jecassis/wave-bubble/Wave Bubble/wavebubble.c

/*
 * wavebubble.c
 *
 * Wave Bubble Hardware Firmware and Tests
 *
 * Firmware to test and operate the Wave Bubble hardware.
 * For questions, bug reports or problems use the forum at:
 * http://forums.adafruit.com/viewforum.php?f=16
 *
 * Copyright (c) 2020 Jimmy Cassis
 *
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
 */

#include "wavebubble.h"

#include <avr/interrupt.h>
#include <avr/pgmspace.h>
#ifndef TEST
#include <avr/cpufunc.h>
#include <avr/eeprom.h>
#include <ctype.h>
#include <util/delay.h>
#else
#include "test.h"
#endif
#include "pll.h"
#include "serial.h"
#include "tuner.h"

#ifdef TEST
volatile char in_char = 0;
#else // OPERATION
uint8_t EEMEM settings_ee;      // Offset to save setting (EEPROM byte offset: 0x06)
uint8_t EEMEM curr_program = 0; // Number of program in use (EEPROM byte offset: 0x05)
uint8_t EEMEM num_programs = 0; // Number of programs in EEPROM (EEPROM byte offset: 0x04)
uint16_t EEMEM validity = 0;    // Validity value to check for empty EEPROM (EEPROM byte offset: 0x02)
uint16_t EEMEM dummy = 0;       // A dummy word to prevent data corruption (EEPROM byte offset: 0x00)

volatile uint16_t global_delay = 0; // Milliseconds delay counter, decremented by ISR
volatile uint16_t led_delay = 0;    // LED blink timer
volatile uint16_t key_delay = 0;    // Key press timer to debounce and detect short and long presses
volatile uint8_t lowbatt_timer = 0; // One second timer for low battery threshold
#endif

/*
 * Power device off
 *
 */
static void power_off(void) {
  usart_puts_P(PSTR("Powering OFF...\n"));
  delay_ms(400);

  // Power OFF device
#ifdef HW_REV_A
  POWERON_PORT |= _BV(POWERON);
#else
  POWERON_PORT &= ~_BV(POWERON);
#endif
}

#ifdef TEST

/*
 * The main test function.
 *
 */
int main(void) {
  // Power on switch pin output and force high to keep device running
  POWERON_PORT |= _BV(POWERON);
  POWERON_DDR |= _BV(POWERON);

  // Initialize serial communication
  usart_init();

  DDRD |= _BV(PD1); // USART TxD0 output

  // LED pin output and LED off
  LEDDDR |= _BV(LED);
  LEDPORT &= ~_BV(LED);

  // Setup port and pins for SPI to digitally-controlled variable resistor
  SPICS_DDR |= _BV(SPICS);
  SPISDO_DDR |= _BV(SPISDO);
  SPICLK_DDR |= _BV(SPICLK);

  SPICS_PORT |= _BV(SPICS);
  SPICLK_PORT &= ~_BV(SPICLK);

  // Setup VCO power control port and pins
  POWERCTL1_DDR |= _BV(POWERCTL1);
  POWERCTL2_DDR |= _BV(POWERCTL2);
  POWERCTL1_PORT &= ~_BV(POWERCTL1); // Turn off VCO1+gain stage
  POWERCTL2_PORT &= ~_BV(POWERCTL2); // Turn off VCO2+gain stage

  // Initialize tuning voltage generator
  init_pwm();

  // Initialize PLL control
  pll_init();

  // Set digital potentiometer to minimum
  set_resistor(BANDWADJ1_RES, 0);
  set_resistor(BANDWADJ2_RES, 0);

  // Set NE555 mode
  set_sawtooth_low();

  usart_puts_P(PSTR("Wave Bubble - Hardware Test\nFW: " __DATE__ " / " __TIME__ "\n\n"));

  usart_puts_P(PSTR("Serial connection test passed.\n\n"));

  usart_puts_P(PSTR("Select a test:\n"));
  usart_puts_P(PSTR("a - Power/Program LED test\n"));             // TP1
  usart_puts_P(PSTR("b - NE555 low frequency mode\n"));           // TP2
  usart_puts_P(PSTR("c - NE555 high frequency mode\n"));          // TP2
  usart_puts_P(PSTR("d - Digital potentiometer sweep\n"));        // TP3 + TP4
  usart_puts_P(PSTR("e - Set digital potentiometer minimum\n"));  // TP3 + TP4
  usart_puts_P(PSTR("f - Set digital potentiometer maximum\n"));  // TP3 + TP4
  usart_puts_P(PSTR("g - Power switch VCO1 (HI) test\n"));        // TP5
  usart_puts_P(PSTR("h - Power switch VCO2 (LO) test\n"));        // TP6
  usart_puts_P(PSTR("i - VCO1 (HI) power toggle\n"));             // TP5
  usart_puts_P(PSTR("j - VCO2 (LO) power toggle\n"));             // TP6
  usart_puts_P(PSTR("k - PWM tuning voltage generator sweep\n")); // TP7 + TP8
  usart_puts_P(PSTR("l - Set PWM tuning voltage minimum\n"));     // TP7 + TP8
  usart_puts_P(PSTR("m - Set PWM tuning voltage maximum\n"));     // TP7 + TP8
  usart_puts_P(PSTR("n - Increase PWM tuning voltage by 1\n"));   // TP7 + TP8
  usart_puts_P(PSTR("o - Decrease PWM tuning voltage by 1\n"));   // TP7 + TP8
  usart_puts_P(PSTR("p - VCO sweep test\n"));                     // TP9 + TP10
  usart_puts_P(PSTR("q - PLL test 1 - DATA signal 5Hz\n"));       // TP11 + TP12
  usart_puts_P(PSTR("r - PLL test 2 - RF stage\n"));              // TP13
  usart_puts_P(PSTR("s - PLL test 2 - IF stage\n"));              // TP14
  usart_puts_P(PSTR("\nz - Power OFF\n"));

  sei();

  uint16_t ocr_val = 0;

  for (;;) {
    switch (in_char) {
      case 'a':
        test_led();
        break;
      case 'b':
        set_sawtooth_low();
        break;
      case 'c':
        set_sawtooth_high();
        break;
      case 'd':
        test_resistors();
        break;
      case 'e':
        set_resistor(BANDWADJ1_RES, 0);
        set_resistor(BANDWADJ2_RES, 0);
        break;
      case 'f':
        set_resistor(BANDWADJ1_RES, 255);
        set_resistor(BANDWADJ2_RES, 255);
        break;
      case 'g':
        test_powerswitch1();
        break;
      case 'h':
        test_powerswitch2();
        break;
      case 'i':
        OCR1A = 0;
        set_resistor(BANDWADJ1_RES, 0);
        POWERCTL2_PORT &= ~_BV(POWERCTL2);
        POWERCTL1_PORT ^= _BV(POWERCTL1);
        in_char = 0;
        break;
      case 'j':
        OCR1B = 0;
        set_resistor(BANDWADJ2_RES, 0);
        POWERCTL1_PORT &= ~_BV(POWERCTL1);
        POWERCTL2_PORT ^= _BV(POWERCTL2);
        in_char = 0;
        break;
      case 'k':
        test_dc();
        break;
      case 'l':
        OCR1A = 0;
        OCR1B = 0;
        ocr_val = 0;
        break;
      case 'm':
        OCR1A = 4095;
        OCR1B = 4095;
        ocr_val = 4095;
        break;
      case 'n':
        if (ocr_val < 4096) {
          ++ocr_val;
          OCR1A = OCR1B = ocr_val;
        }
        in_char = 0;
        break;
      case 'o':
        if (ocr_val > 0) {
          --ocr_val;
          OCR1A = OCR1B = ocr_val;
        }
        in_char = 0;
        break;
      case 'p':
        test_vcos();
        break;
      case 'q':
        test_pll1();
        break;
      case 'r':
        test_pll2_rf();
        break;
      case 's':
        test_pll2_if();
        break;
      case 'z':
        power_off();
        break;
      default:
        break;
    }
  }

  return 0;
}

#else // OPERATION

/*
 * Milliseconds delay function using 1ms system tick from timer0.
 *
 * ms: Number of milliseconds to delay
 *
 */
void delay_ms(uint16_t ms) {
  global_delay = ms;

  // `global_delay' will be decreased in timer 0's ISR
  while (global_delay > 0) {
    _NOP();
  }
}

/*
 * Check the validity of EEPROM content and initialize if necessary.
 *
 */
static void init_eeprom(void) {
  uint16_t i, temp;
  uint8_t *p = 0;

  // Read validity word
  temp = eeprom_read_word(&validity);

  // Check validity, 0xBEEF is good here.
  if (temp != 0xEFBE) { // Not correct? Init EEPROM.
    for (i = 0; i < E2END + 1; ++i) {
      eeprom_write_byte(p++, 0x00);
    }
  }
  eeprom_write_word(&validity, 0xEFBE);
}

/*
 * Print menu on terminal.
 *
 */
static void print_menu(void) {
  print_div();
  usart_puts_P(PSTR("p - Display programs\n"));
  usart_puts_P(PSTR("a - Add program\n"));
  usart_puts_P(PSTR("t - Tune program\n"));
  usart_puts_P(PSTR("d - Delete program\n"));
  usart_puts_P(PSTR("e - Delete all programs\n"));
  usart_puts_P(PSTR("q - Quit menu\n"));
  usart_puts_P(PSTR("o - Power off\n"));
  print_div();
  usart_puts_P(PSTR("=> "));
}

/*
 * Print program details on terminal.
 *
 * setting: Jammer setting struct
 * n:       Program number
 * m:       Total number of programs
 *
 */
static void print_program(jammer_setting *setting, uint8_t n, uint8_t m) {
  usart_puts_P(PSTR("Program number "));
  putnum_ud(n + 1);
  usart_puts_P(PSTR(" of "));
  putnum_ud((uint16_t)m);
  usart_putc('\n');

  usart_puts_P(PSTR("Low band VCO: "));
  if (setting->startfreq2 == 0) {
    usart_puts_P(PSTR("Off"));
  } else {
    putnum_ud(setting->startfreq2);
    usart_puts_P(PSTR(" -> "));
    putnum_ud(setting->endfreq2);
    usart_puts_P(PSTR(" ("));
    putnum_ud(setting->dc_offset2);
    usart_puts_P(PSTR(", "));
    putnum_ud(setting->bandwidth2);
    usart_putc(')');
  }
  usart_puts_P(PSTR("\nHigh band VCO: "));
  if (setting->startfreq1 == 0) {
    usart_puts_P(PSTR("Off"));
  } else {
    putnum_ud(setting->startfreq1);
    usart_puts_P(PSTR(" -> "));
    putnum_ud(setting->endfreq1);
    usart_puts_P(PSTR(" ("));
    putnum_ud(setting->dc_offset1);
    usart_puts_P(PSTR(", "));
    putnum_ud(setting->bandwidth1);
    usart_putc(')');
  }
  usart_puts_P(PSTR("\n\n"));
}

/*
 * Print all programs on terminal.
 *
 */
static void display_programs(void) {
  uint8_t i, progs;
  jammer_setting setting;

  progs = eeprom_read_byte(&num_programs);
  if (progs > MAX_PROGRAMS) {
    progs = MAX_PROGRAMS;
  }

  putnum_ud(progs);
  usart_puts_P(PSTR(" of "));
  putnum_ud(MAX_PROGRAMS);
  usart_puts_P(PSTR(" programs in memory.\n\n"));

  for (i = 0; i < progs; ++i) {
    eeprom_read_block(&setting,
                      &settings_ee + sizeof(jammer_setting) * i,
                      sizeof(jammer_setting));
    print_program(&setting, i, progs);
  }
}

/*
 * Delete program from EEPROM.
 *
 */
static void delete_program(void) {
  uint8_t n, progs;
  jammer_setting setting;

  if (eeprom_read_byte(&num_programs) == 0) {
    usart_puts_P(PSTR("No programs stored.\n\n"));
    return;
  }

  display_programs();
  usart_puts_P(PSTR("Delete program number: "));
  n = usart_get16();
  progs = eeprom_read_byte(&num_programs);
  if (progs > MAX_PROGRAMS) {
    progs = MAX_PROGRAMS;
  }

  if ((n == 0) || (n > progs)) {
    usart_puts_P(PSTR("Invalid program number.\n\n"));
    return;
  }

  if (n == progs) {
    // Reduce program count
    eeprom_write_byte(&num_programs, progs - 1);
  } else {
    // Delete desired program
    for (; n < progs; ++n) {
      // Shift trailing program blocks
      eeprom_read_block(&setting,
                        &settings_ee + sizeof(jammer_setting) * n,
                        sizeof(jammer_setting));

      eeprom_write_block(&setting,
                         &settings_ee + sizeof(jammer_setting) * (n - 1),
                         sizeof(jammer_setting));

      // Remove deleted program from count
      eeprom_write_byte(&num_programs, progs - 1);
    }
  }
  usart_putc('\n');
}

/*
 * Tune setting on VCOs and save tuning values.
 *
 * n:    Number of program to tune
 * save: If true, save back tuning values
 *
 */
static void tune_it(uint8_t n, uint8_t save) {
  jammer_setting setting;

  eeprom_read_block(&setting,
                    &settings_ee + sizeof(jammer_setting) * n,
                    sizeof(jammer_setting));

  // Tune low band VCO
  if ((setting.startfreq2 != 0) && (setting.endfreq2 != 0)) {
    setting.bandwidth2 = tune_rf_band(setting.startfreq2, setting.endfreq2, 1);
    setting.dc_offset2 = OCR1B;
  }

  // Tune high band VCO
  if ((setting.startfreq1 != 0) && (setting.endfreq1 != 0)) {
    setting.bandwidth1 = tune_rf_band(setting.startfreq1, setting.endfreq1, 0);
    setting.dc_offset1 = OCR1A;
  }

  if (save) {
    eeprom_write_block(&setting,
                       &settings_ee + sizeof(jammer_setting) * n,
                       sizeof(jammer_setting));
  }
}

/*
 * Tune specific program.
 *
 */
static void tune_program(void) {
  uint8_t n;

  if (eeprom_read_byte(&num_programs) == 0) {
    usart_puts_P(PSTR("No programs stored.\n\n"));
    return;
  }

  display_programs();
  usart_puts_P(PSTR("Tune program number: "));
  n = usart_get16();
  if (n > eeprom_read_byte(&num_programs)) {
    usart_puts_P(PSTR("Invalid program number.\n\n"));
  } else {
    tune_it(n - 1, 1);
  }
}

/*
 * Add program to jammer and store in EEPROM
 *
 */
static void add_program(void) {
  jammer_setting new_setting;
  uint8_t progs;

  progs = eeprom_read_byte(&num_programs);
  if (progs >= MAX_PROGRAMS) {
    usart_puts_P(PSTR("Memory full.\n\n"));
    return;
  }

  usart_puts_P(PSTR("Enter start and stop frequency for each VCO or 0 to turn off VCO.\n"));
  usart_puts_P(PSTR("Low Band: 345-1350MHz -- High Band 1225-2715MHz\n"));

lowbandstart:
  usart_puts_P(PSTR("\nLow band VCO\nStart (in MHz): "));
  new_setting.startfreq2 = usart_get16();
  if (new_setting.startfreq2 == 0) {
    new_setting.endfreq2 = 0;
    goto highbandstart;
  }
  if (new_setting.startfreq2 < LOWBAND_VCO_LOW) {
    usart_puts_P(PSTR("Frequency too low.\n"));
    goto lowbandstart;
  }

lowbandend:
  usart_puts_P(PSTR("End (in MHz): "));
  new_setting.endfreq2 = usart_get16();
  if (new_setting.endfreq2 == 0) {
    new_setting.startfreq2 = 0;
    goto highbandstart;
  }
  if (new_setting.endfreq2 > LOWBAND_VCO_HIGH) {
    usart_puts_P(PSTR("Frequency too high.\n"));
    goto lowbandend;
  }
  if (new_setting.endfreq2 < new_setting.startfreq2) {
    usart_puts_P(PSTR("End frequency lower than start.\n"));
    goto lowbandend;
  }

highbandstart:
  usart_puts_P(PSTR("\nHigh band VCO\nStart (in MHz): "));
  new_setting.startfreq1 = usart_get16();
  if (new_setting.startfreq1 == 0) {
    new_setting.endfreq1 = 0;
    goto saveprog;
  }
  if (new_setting.startfreq1 < HIGHBAND_VCO_LOW) {
    usart_puts_P(PSTR("Frequency too low.\n"));
    goto highbandstart;
  }

highbandend:
  usart_puts_P(PSTR("End (in MHz): "));
  new_setting.endfreq1 = usart_get16();
  if (new_setting.endfreq1 == 0) {
    new_setting.startfreq1 = 0;
    goto saveprog;
  }
  if (new_setting.endfreq1 > HIGHBAND_VCO_HIGH) {
    usart_puts_P(PSTR("Frequency too high.\n"));
    goto highbandend;
  }
  if (new_setting.endfreq1 < new_setting.startfreq1) {
    usart_puts_P(PSTR("End frequency lower than start.\n"));
    goto highbandend;
  }

saveprog:
  if ((new_setting.startfreq1 == 0) && (new_setting.startfreq2 == 0)) {
    usart_puts_P(PSTR("\nNothing to save.\n\n"));
    return;
  }
  new_setting.dc_offset1 = new_setting.dc_offset2 = 0;
  new_setting.bandwidth1 = new_setting.bandwidth2 = 0;

  eeprom_write_block(&new_setting,
                     &settings_ee + sizeof(jammer_setting) * progs,
                     sizeof(jammer_setting));

  eeprom_write_byte(&num_programs, progs + 1);
  usart_puts_P(PSTR("\nSaved program number "));
  putnum_ud(progs + 1);
  usart_puts_P(PSTR(".\n\n"));
}

/*
 * Print menu and wait for users input.
 *
 */
static void run_menu(void) {
  char c;

  do {
    print_menu();
    c = usart_getc();
    usart_putc(c);
    usart_putc('\n');
    switch (c) {
      case 'p':
        display_programs();
        break;
      case 'a':
        add_program();
        break;
      case 't':
        tune_program();
        break;
      case 'd':
        delete_program();
        break;
      case 'e':
        usart_puts_P(PSTR("Delete all programs? y/n: "));
        c = usart_getc();
        usart_putc(c);
        usart_puts_P(PSTR("\n\n"));
        if (c == 'y') {
          eeprom_write_word(&validity, 0x0000);
          init_eeprom();
        }
        break;
      case 'q':
        break;
      case 'o':
        power_off();
        break;
      default:
        usart_puts_P(PSTR("Unknown command.\n\n"));
        break;
    }
  } while (c != 'q');
}

/*
 * The main operational function.
 *
 */
int main(void) {
  // Calibrate internal RC oscillator
  // 0x5A read from ATmega168
  // OSCCAL = 0xC0;

  // Setup system tick counter
  OCR0A = 125; // timer0 capture at 1ms
  TCCR0A |= _BV(WGM01);
  TCCR0B |= _BV(CS01) | _BV(CS00); // Set timer0 CTC mode, prescaler 64
  TIMSK0 |= _BV(OCIE0A);           // Enable timer0 output compare interrupt

  sei(); // Enable global interrupts

  key_delay = 0;
  // Power key must be pressed at least 2 seconds to power ON
  while (key_delay < 2000) {
    _NOP();
  }

  // Power ON switch pin output and force HIGH to keep device running
  POWERON_PORT |= _BV(POWERON);
  POWERON_DDR |= _BV(POWERON);

  // Initialize serial communication
  usart_init();

  DDRD |= _BV(PD1); // USART TxD0 output

  // LED pin output and LED on
  LEDDDR |= _BV(LED);
  LEDPORT |= _BV(LED);

  // Program key input and pull-up
  PROGKEY_PORT |= _BV(PROGKEY);
  PROGKEY_DDR &= ~_BV(PROGKEY);

  // Setup port and pins for software SPI operation to control digital potentiometer
  SPICS_DDR |= _BV(SPICS);
  SPISDO_DDR |= _BV(SPISDO);
  SPICLK_DDR |= _BV(SPICLK);

  SPICS_PORT |= _BV(SPICS);
  SPICLK_PORT &= ~_BV(SPICLK);

  // Setup VCO power control port and pins
  POWERCTL1_DDR |= _BV(POWERCTL1);
  POWERCTL2_DDR |= _BV(POWERCTL2);
  POWERCTL1_PORT &= ~_BV(POWERCTL1); // Turn off VCO1 and gain stage
  POWERCTL2_PORT &= ~_BV(POWERCTL2); // Turn off VCO2 and gain stage

  // Initialize tuning voltage generator
  init_pwm();

  // Initialize PLL control
  pll_init();

  // Set digital potentiometer to minimum
  set_resistor(BANDWADJ1_RES, 0);
  set_resistor(BANDWADJ2_RES, 0);

  // Set NE555 mode
  set_sawtooth_low();

  // Check EEPROM validity
  init_eeprom();

  usart_puts_P(PSTR("Wave Bubble\nFW: " __DATE__ " / " __TIME__ "\n\n"));

  uint8_t progs, program_num;
  jammer_setting setting;

  progs = eeprom_read_byte(&num_programs);
  if (progs > MAX_PROGRAMS) {
    progs = MAX_PROGRAMS;
  }

  if (progs != 0) {
    usart_puts_P(PSTR("Press key to enter menu...\n"));
    delay_ms(2000);
  }

no_progs: // Go here in case 'q' is pressed and no programs are stored
  if ((UCSR0A & _BV(RXC0)) && isascii(usart_getc())) {
    usart_putc('\n');
    run_menu();
  } else if (progs == 0) {
    run_menu();
  }

run_prog: // Go here when program key is pressed, switch to next program
  progs = eeprom_read_byte(&num_programs);
  if (progs == 0) {
    usart_puts_P(PSTR("No programs stored.\n\n"));
    goto no_progs;
  } else if (progs > MAX_PROGRAMS) {
    progs = MAX_PROGRAMS;
  } else if (progs != 0) {
    usart_putc('\n');
    print_div();
  }

  program_num = eeprom_read_byte(&curr_program);
  if (program_num >= progs) {
    program_num = 0;
  }

  eeprom_read_block(&setting,
                    &settings_ee + sizeof(jammer_setting) * program_num,
                    sizeof(jammer_setting));

  usart_putc('\n');
  print_program(&setting, program_num, progs);
  print_div();

  if ((setting.dc_offset1 == 0) && (setting.bandwidth1 == 0) &&
      (setting.dc_offset2 == 0) && (setting.bandwidth2 == 0)) {
    tune_it(program_num, 0); // Memory check return
  } else {
    if (setting.startfreq1 != 0) {
      OCR1A = setting.dc_offset1;
      set_resistor(BANDWADJ1_RES, setting.bandwidth1);
      POWERCTL1_PORT |= _BV(POWERCTL1); // Turn on VCO1 and gain stage
    }
    if (setting.startfreq2 != 0) {
      OCR1B = setting.dc_offset2;
      set_resistor(BANDWADJ2_RES, setting.bandwidth2);
      POWERCTL2_PORT |= _BV(POWERCTL2); // Turn on VCO2 and gain stage
    }
  }

  uint8_t key_press = 0, led_count = 0;

  for (;;) {
    // Check battery voltage
    uint16_t batt = 0;
    ADMUX = LOWBATT_ADC_MUX_SELECT;
    ADCSRA |= _BV(ADSC);
    loop_until_bit_is_clear(ADCSRA, ADSC);
    batt = ADC;
#ifdef DEBUG
    putnum_ud(batt);
    usart_putc('\n');
#endif

    if (batt > LOWBATT_MINIMUM) {
      // Reset low battery timer
      // 100ms = 100 x 1ms time for low battery before power off
      lowbatt_timer = 100;
    }

    if (lowbatt_timer == 0) {
      // Power off device
#ifdef HW_REV_A
      POWERON_PORT |= _BV(POWERON);
#else
      POWERON_PORT &= ~_BV(POWERON);
#endif
      while (1) {}
    }

    // Check if a key was pressed earlier
    if (key_press) {
      // Check if key has been released
      if (bit_is_set(PROGKEY_PIN, PROGKEY)) {
        // Key is released
        if ((key_delay > 0) && (key_delay <= 800)) { // Short keypress
          LEDPORT &= ~_BV(LED);                      // Turn LED off
          POWERCTL1_PORT &= ~_BV(POWERCTL1);         // Turn VCO1 off
          POWERCTL2_PORT &= ~_BV(POWERCTL2);         // Turn VCO2 off
          eeprom_write_byte(&curr_program, program_num + 1);
          goto run_prog;
        }
        key_press = 0;
      } else if ((key_delay > 800) && (key_delay <= 5000)) { // Long keypress
        power_off();
      }
    } else {
      // Check if key is pressed
      if (bit_is_clear(PROGKEY_PIN, PROGKEY)) {
        key_delay = 0; // Reset key press timer
        key_press = 1;
      }
    }

    // Indicate selected program with blinking LED by blinking
    // the program number of times followed by a 1s pause
    if (led_delay == 0) {
      if (led_count == 0) {
        led_count = program_num + 1;
        led_delay = 1000;
      } else {
        if (bit_is_clear(LEDPORT, LED)) {
          LEDPORT |= _BV(LED);
          if (led_count == 0) {
            led_delay = 1000;
          } else {
            led_delay = 100;
          }
        } else {
          LEDPORT &= ~_BV(LED);
          led_delay = 300;
          --led_count;
        }
      }
    }
  }

  return 0;
}

/*
 * Timer 0 OCR interrupt service routine with 1ms system tick.
 *
 */
ISR(TIMER0_COMPA_vect) {
  if (global_delay > 0) {
    --global_delay;
  }

  if (led_delay > 0) {
    --led_delay;
  }

  if (lowbatt_timer > 0) {
    --lowbatt_timer;
  }

  ++key_delay;
}

#endif
