jecassis/wave-bubble/(commit log)

2020-03-03 Add main board EAGLE schematics and board layout
    [MAIN BOARD.brd, MAIN BOARD.sch]
2020-03-03 Replace tests with firmware
    [pll.c, pll.h, serial.c, serial.h]
2020-03-08 Fix serial text garbage bug and EEPROM address layout bug in addition to code cleanup
    [pll.c, pll.h, serial.c, wavebubble.c, wavebubble.h]
2020-03-08 Reimplement PLL and variable resistor configuration protocols with comments
2020-03-09 Make spacing consistent in serial printouts
